npol/Build18_2015/Analog/MCU_Pinouts.xlsx

Sheet: Gate
Pin | Function | Use | Peripheral | Clk
1 | DVCC | 3.3V | Supply | N/A
2 | P1.0/TA0CLK/ACLK/A0/CA0 | LED | P1.0 | N/A
3 | P1.1/TA0.0/UCA0RXD/UCA0SOMI/A1/CA1 | RXD | UCA0_UART | ACLK/1
4 | P1.2/TA0.1/UCA0TXD/UCA0SIMO/A2/CA2 | TXD | UCA0_UART | ACLK/1
5 | P1.3/ADC10CLK/CAOUT/VREF-/VEREF-/A3/CA3 | RFID_RX | ADC3
6 | P1.4/SMCLK/UCB0STE/UCA0CLK/VREF+/VEREF+/A4/CA4 | CS | UCB0_SPI | ACLK/8
7 | P1.5/TA0.0/UCB0CLK/UCA0STE/A5/CA5/TMS | SCK | UCB0_SPI | ACLK/8
8 | P2.0/TA1.0 | GDO0 | P2.1 | N/A
9 | P2.1/TA1.1 | RFID_TX | TA1.1 | ACLK/1
10 | P2.2/TA1.1 | GDO2 | P2.2 | N/A
11 | P2.3/TA1.0 | ID0 | P2.3 | N/A
12 | P2.4/TA1.2 | ID1 | P2.4 | N/A
13 | P2.5/TA1.2 | ID2 | P2.5 | N/A
14 | P1.6/TA0.1/UCB0SOMI/UCB0SCL/A6/CA6/TDI/TCLK | MISO | UCB0_SPI | ACLK/8
15 | P1.7/CAOUT/UCB0SIMO/UCB0SDA/A7/CA7/TDO/TDI | MOSI | UCB0_SPI | ACLK/8
16 | /RST/NMI/SBWTDIO | RST | Prgm | N/A
17 | TEST/SBWTCK |  | Prgrm | N/A
18 | XOUT/P2.7 | XOUT | XTAL | N/A
19 | XIN/P2.6/TA0.1 | XIN | XTAL | N/A
20 | DVSS | GND | Supply | N/A

Sheet: Car-RF
Pin | Function | Use | Peripheral | Clk | RFID_RX1
1 | DVCC | 3.3V | Supply | N/A | RFID_RX2
2 | P1.0/TA0CLK/ACLK/A0/CA0 |  |  |  | RFID_TX
3 | P1.1/TA0.0/UCA0RXD/UCA0SOMI/A1/CA1 | RF_RXD | UCA0_UART | ACLK/1
4 | P1.2/TA0.1/UCA0TXD/UCA0SIMO/A2/CA2 | RF_TXD | UCA0_UART | ACLK/1
5 | P1.3/ADC10CLK/CAOUT/VREF-/VEREF-/A3/CA3 |  |  |  | CS
6 | P1.4/SMCLK/UCB0STE/UCA0CLK/VREF+/VEREF+/A4/CA4
7 | P1.5/TA0.0/UCB0CLK/UCA0STE/A5/CA5/TMS | SCK | UCB0_SPI | ACLK/8
8 | P3.1/TA1.0
9 | P3.0/TA0.2 |  |  |  | GDO0
10 | P2.0/TA1.0 |  |  |  | GDO2
11 | P2.1/TA1.1 |  |  |  | Step
12 | P2.2/TA1.1 |  |  |  | Dir
13 | P3.2/TA1.1 |  |  |  | En
14 | P3.3/TA1.2
15 | P3.4/TA0.0 | ENABLE
16 | P2.3/TA1.0 | DIR
17 | P2.4/TA1.2 | STEP
18 | P2.5/TA1.2
19 | P3.5/TA0.1
20 | P3.6/TA0.2
21 | P3.7/TA0.2
22 | P1.6/TA0.1/UCB0SOMI/UCB0SCL/A6/CA6/TDI/TCLK | MISO | UCB0_SPI | ACLK/8 | Opto
23 | P1.7/CAOUT/UCB0SIMO/UCB0SDA/A7/CA7/TDO/TDI | MOSI | UCB0_SPI | ACLK/8 | LED
24 | /RST/NMI/SBWTDIO | RST | Prgm | N/A | MUX_EN
25 | TEST/SBWTCK |  | Prgrm | N/A | MUX_A0
26 | XOUT/P2.7 | XOUT | XTAL | N/A | MUX_A1
27 | XIN/P2.6/TA0.1 | XIN | XTAL | N/A | Gate1
28 | DVSS | GND | Supply | N/A | Gate2
 |  |  | opto input?

Sheet: Car-Motor
Pin | Function | Use | Peripheral | Clk
1 | DVCC | 3.3V | Supply | N/A
2 | P1.0/TA0CLK/ACLK/A0/CA0 | LED | P1.0 | N/A
3 | P1.1/TA0.0/UCA0RXD/UCA0SOMI/A1/CA1 | RXD | UCA0_UART | ACLK/1
4 | P1.2/TA0.1/UCA0TXD/UCA0SIMO/A2/CA2 | TXD | UCA0_UART | ACLK/1
5 | P1.3/ADC10CLK/CAOUT/VREF-/VEREF-/A3/CA3
6 | P1.4/SMCLK/UCB0STE/UCA0CLK/VREF+/VEREF+/A4/CA4
7 | P1.5/TA0.0/UCB0CLK/UCA0STE/A5/CA5/TMS
8 | P2.0/TA1.0 | A0 | P2.0
9 | P2.1/TA1.1 | A1 | OUT1.1
10 | P2.2/TA1.1 | SLEEP | P2.2
11 | P2.3/TA1.0 | B0 | P2.3
12 | P2.4/TA1.2 | B1 | OUT1.2
13 | P2.5/TA1.2 | FAULT | P2.5
14 | P1.6/TA0.1/UCB0SOMI/UCB0SCL/A6/CA6/TDI/TCLK
15 | P1.7/CAOUT/UCB0SIMO/UCB0SDA/A7/CA7/TDO/TDI
16 | /RST/NMI/SBWTDIO | RST | Prgm | N/A
17 | TEST/SBWTCK |  | Prgrm | N/A
18 | XOUT/P2.7 | XOUT | XTAL | N/A
19 | XIN/P2.6/TA0.1 | XIN | XTAL | N/A
20 | DVSS | GND | Supply | N/A
