npol/Build18_2015/Mobile_Robot_Localization_Parts_List.xlsx

Part Link | Note | Quantity | Est. Cost per unit | Subtotal
http://www.pololu.com/product/2213 | 50:1 Micro metal gearmotor with encoder shaft | 2 | 16.95 | 33.9 | Project Name: | Total Spent:
http://www.pololu.com/product/2591 | Optical encoder pair, 3.3V | 1 | 8.95 | 8.95 | Mobile Robot Localization using RFID | 299.704
http://www.pololu.com/product/1086 | Motor bracket, white | 1 | 4.99 | 4.99
http://www.pololu.com/product/1435 | Wheel 90x10mm Pair Black | 1 | 9.95 | 9.95
http://www.pololu.com/product/951 | Ball Caster 3/8 metal ball | 1 | 2.99 | 2.99
http://www.amazon.com/Magnet-Enameled-Copper-Length-Diameter/dp/B00BJMVMQE | Amazon B00BJMVMQE 22AWG Magnet Wire | 2 | 15.98 | 31.96
http://www.amazon.com/Cast-Acrylic-Sheet-Clear-0-177/dp/B00JB7FEEU | Amazon B006GHT9NA 0.177Thick 12"x24" acrylic sheet, clear | 2 | 15.88 | 31.76 | Point of Contact
http://www.amazon.com/StarTech-com-Thermal-Compound-Heatsink-SILVGREASE1/dp/B00006B8DX | Amazon B00006B8DX Thermal Paste | 1 | 2.99 | 2.99 | npol@andrew.cmu.edu
N/A-Osh Park | Gate PCB: Will purchase, and ask for reimbursement | 1 | 30 | 30
N/A-Osh Park | Car PCB: Will purchase, and ask for reimbursement | 1 | 35 | 35
http://www.digikey.com/product-detail/en/MSP430G2353IPW20/296-33456-5-ND/2695675 | Digikey 296-33456-5-ND MSP430G2353IPW20 Microcontroller | 10 | 0.1764 | 1.764
http://www.digikey.com/product-search/en?KeyWords=QFM-TRX1-24G-ND&WT.z_header=search_go | Digikey QFM-TRX1-24G-ND 2.4GHz Radio | 4 | 6.78 | 27.12
http://www.digikey.com/product-detail/en/951108-8622-AR/3M9327-ND/1959055 | Digikey 3M9327-ND 2mm 8x1 pins | 2 | 0.51 | 1.02
http://www.digikey.com/product-search/en?KeyWords=S5751-08-ND&WT.z_header=search_go | Digikey S5751-08-ND 2mm 8x1 socket | 4 | 1.11 | 4.44
http://www.digikey.com/product-detail/en/OPA564AIDWDR/296-25453-1-ND/2187253 | Digikey 296-25453-1-ND OPA564IDWDR | 3 | 7.13 | 21.39
http://www.digikey.com/product-detail/en/OPA2134UA%2F2K5/296-22024-1-ND/301154 | Digikey 296-22024-1-ND OPA2134UA/2K5 | 5 | 3.63 | 18.15
http://www.digikey.com/product-detail/en/LMC6482IMX%2FNOPB/LMC6482IMX%2FNOPBCT-ND/3440141 | Digikey LMC6482IMX/NOPBCT-ND LMC6482IMX/NOPB | 5 | 1.75 | 8.75
http://www.digikey.com/product-search/en?KeyWords=CTX900-ND&WT.z_header=search_go | Digikey CTX900-ND 8MHz Crystal | 10 | 0.3 | 3
http://www.digikey.com/product-detail/en/1N4732A/1N4732AFS-ND/977205 | Digikey 1N4732AFS-ND 1N4732A | 10 | 0.209 | 2.09
http://www.digikey.com/product-detail/en/1N4742A/1N4742AFS-ND/977257 | Digikey 1N4742AFS-ND 1N4742A | 10 | 0.209 | 2.09
http://www.digikey.com/product-detail/en/SMS3922-015LF/863-1108-1-ND/2052240 | Digikey 863-1108-1-ND SMS3922-015LF | 3 | 0.71 | 2.13
http://www.digikey.com/product-search/en?KeyWords=LM2574N-5.0%2FNOPB-ND&WT.z_header=search_go | Digikey LM2574N-5.0/NOPB-ND LM2574-5.0 | 2 | 1.99 | 3.98
http://www.digikey.com/product-search/en?KeyWords=553-1558-5-ND&WT.z_header=search_go | Digikey 553-1558-5-ND 330uH inductor | 1 | 3.15 | 3.15
http://www.digikey.com/product-detail/en/2N7002P,215/568-5818-1-ND/2531105 | Digikey 568-5818-1-ND 2N7002P SOT-23 | 10 | 0.127 | 1.27
http://www.digikey.com/product-detail/en/BS250FTA/BS250FCT-ND/53566 | Digikey BS250FCT-ND BS250FTA | 2 | 0.7 | 1.4
http://www.digikey.com/product-detail/en/MAX4518CSD%2B/MAX4518CSD%2B-ND/1780268 | Digikey MAX4518CSD+-ND Analog Multiplexer | 1 | 2.08 | 2.08
http://www.digikey.com/product-search/en?KeyWords=425-1948-5-ND&WT.z_header=search_go | Digikey 425-1948-5-ND Optointerrupter | 1 | 1.43 | 1.43
http://www.digikey.com/product-detail/en/LD1117D33CTR/497-1230-1-ND/586230 | Digikey 497-1230-1-ND LD1117D33CTR | 4 | 0.49 | 1.96
 |  |  |  | 0
 |  |  |  | 0
 |  |  |  | 0
 |  |  |  | 0
 |  |  |  | 0
 |  |  |  | 0
 |  |  |  | 0
 |  |  |  | 0
 |  |  |  | 0
 |  |  |  | 0
 |  |  |  | 0
 |  |  |  | 0
 |  |  |  | 0
 |  |  |  | 0
 |  |  |  | 0
 |  |  |  | 0
 |  |  |  | 0
 |  |  |  | 0
 |  |  |  | 0
 |  |  |  | 0
 |  |  |  | 0
 |  |  |  | 0
 |  |  |  | 0
 |  |  |  | 0
 |  |  |  | 0
 |  |  |  | 0
