npol/Build18_2015/Analog/Robot/BBB Setup.docx

BBB Setup

UART testing

Port 1 OK, /dev/ttyO1

Port 2 OK, /dev/ttyO2

Port 3 not working

Port 4 OK, /dev/ttyO4

Port 5 not working

GPIO testing

P8_26 works

P8_19 works
