npol/Build18_2015/Analog/RFID_Scanner/tests/scanner_prelim/bias_filter_opa2312.png

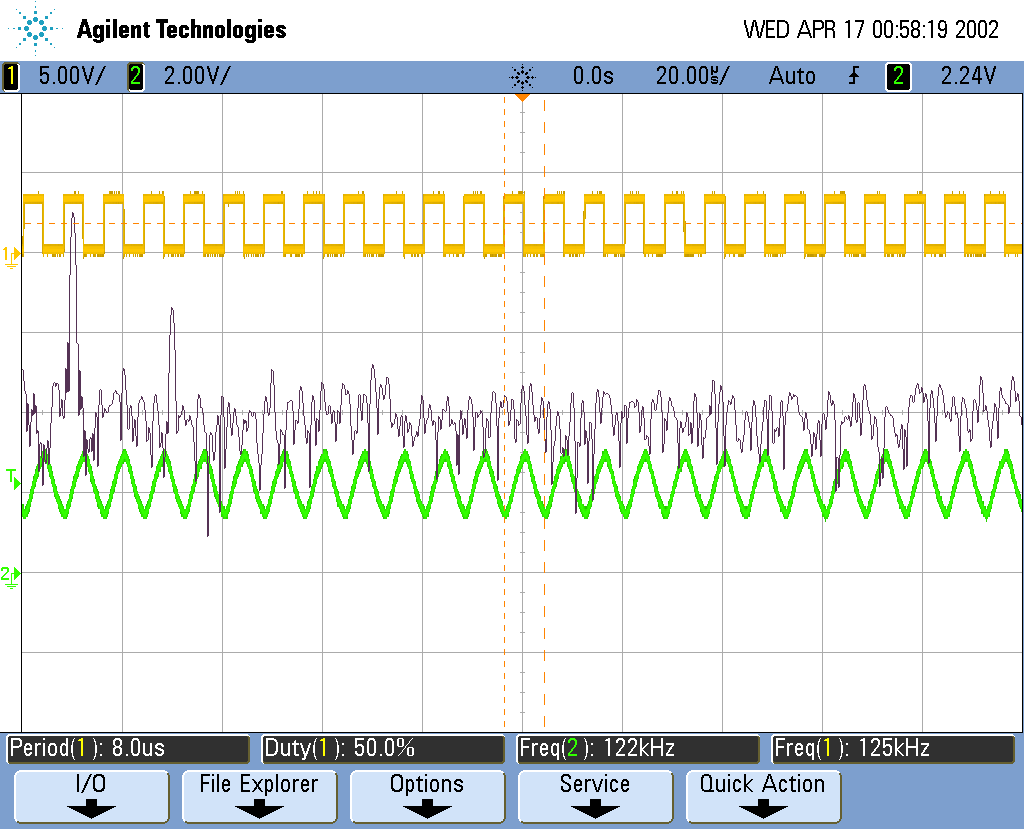
Analog/RFID_Scanner/tests/scanner_prelim/bias_filter_opa2312.png
