npol/Build18_2015/Analog/RFID_Scanner/tests/scanner_prelim/OPA547_follower_sine.png

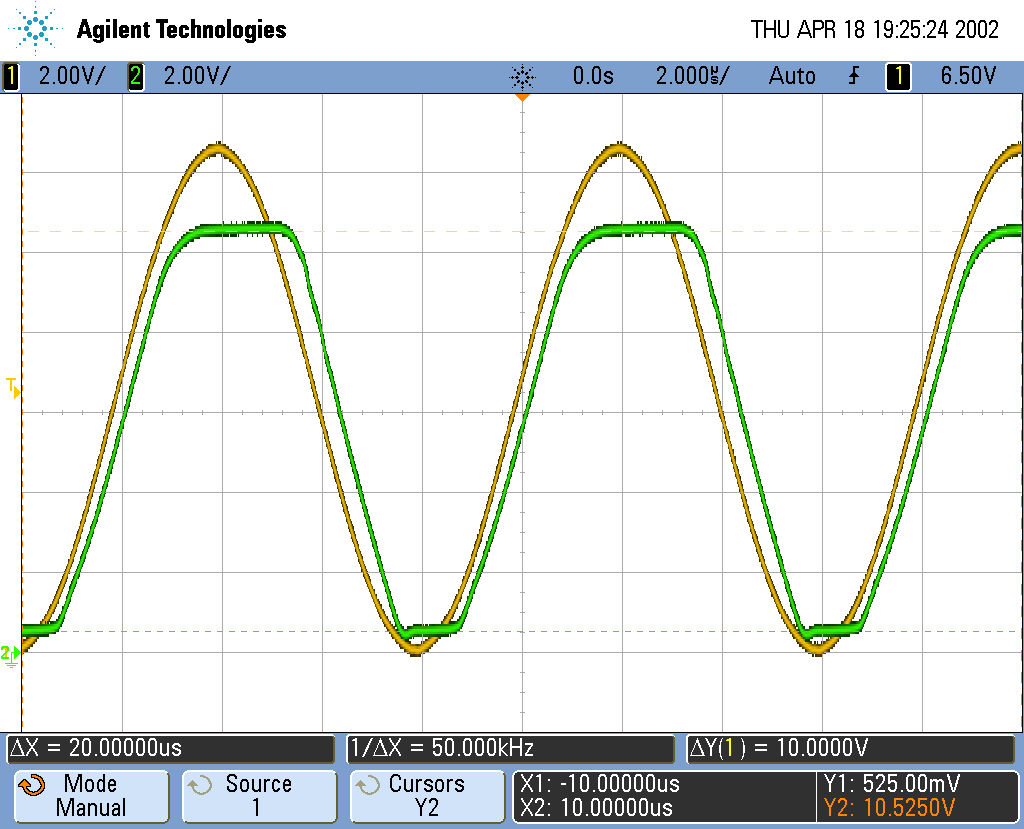
Analog/RFID_Scanner/tests/scanner_prelim/OPA547_follower_sine.png
