npol/Build18_2015/Analog/RFID_Scanner/tests/scanner_prelim/Tx_OPA547_noload.png

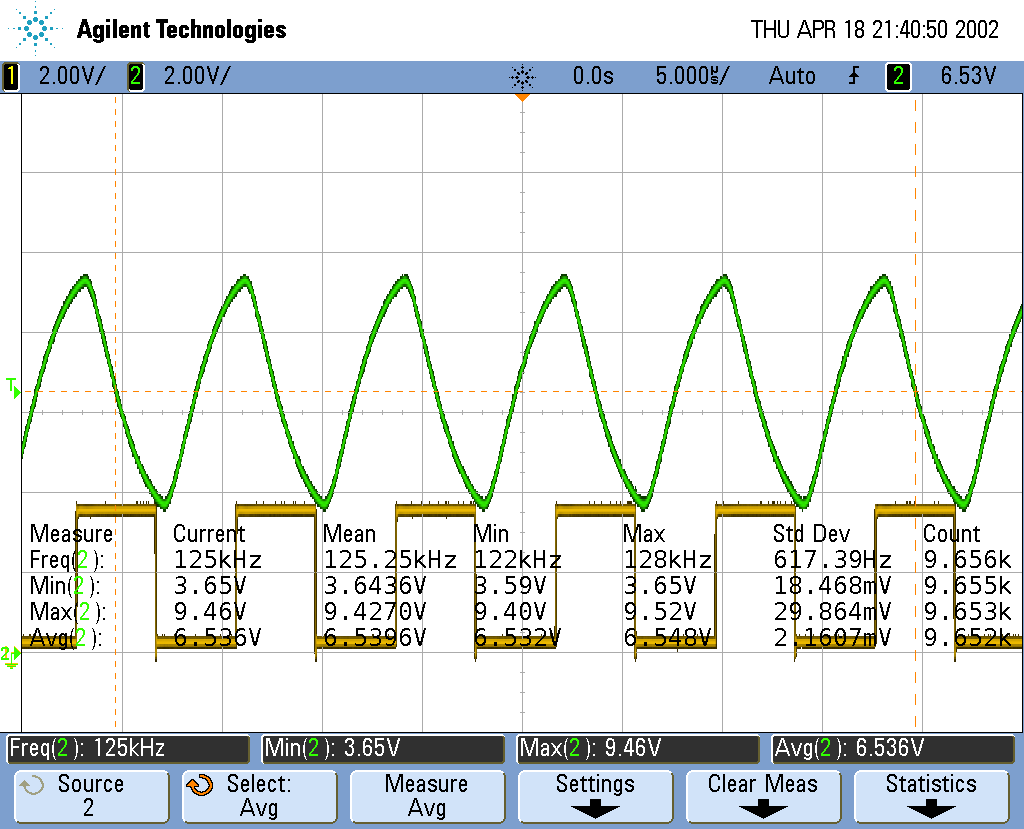
Analog/RFID_Scanner/tests/scanner_prelim/Tx_OPA547_noload.png
