npol/Build18_2015/Analog/RFID_Scanner/tests/scanner_prelim/Tx_slew.png

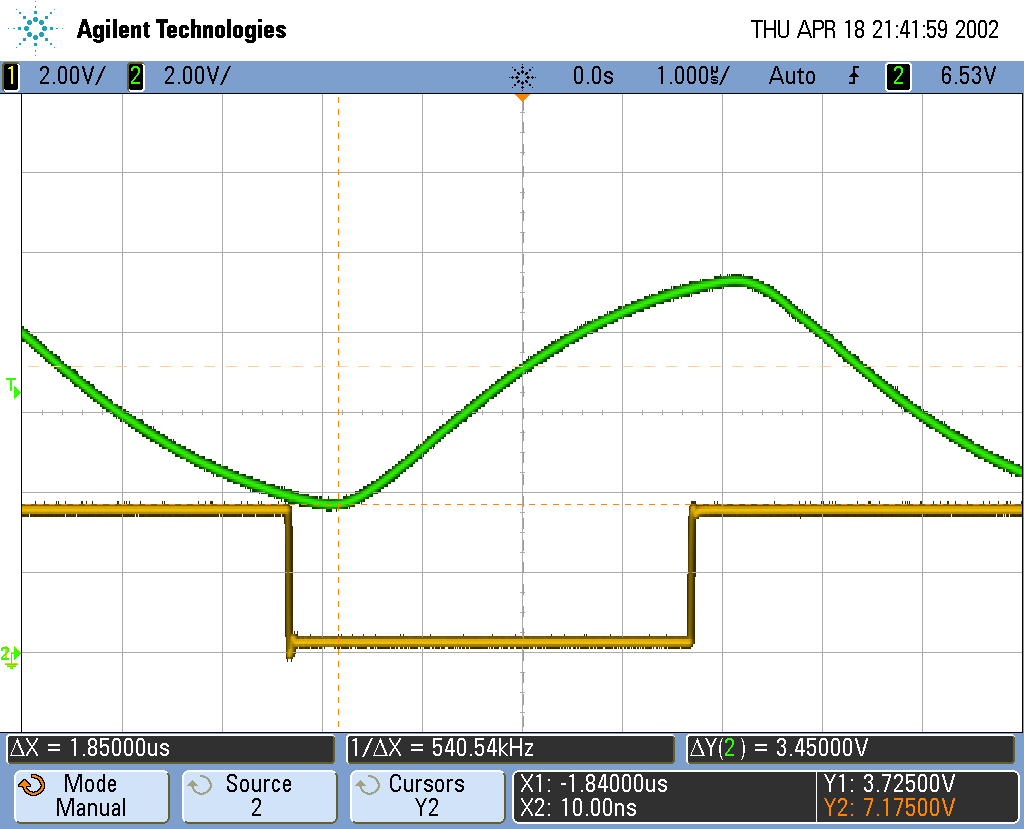
Analog/RFID_Scanner/tests/scanner_prelim/Tx_slew.png
