npol/Build18_2015/Analog/Robot/PCB/Shield.pdf

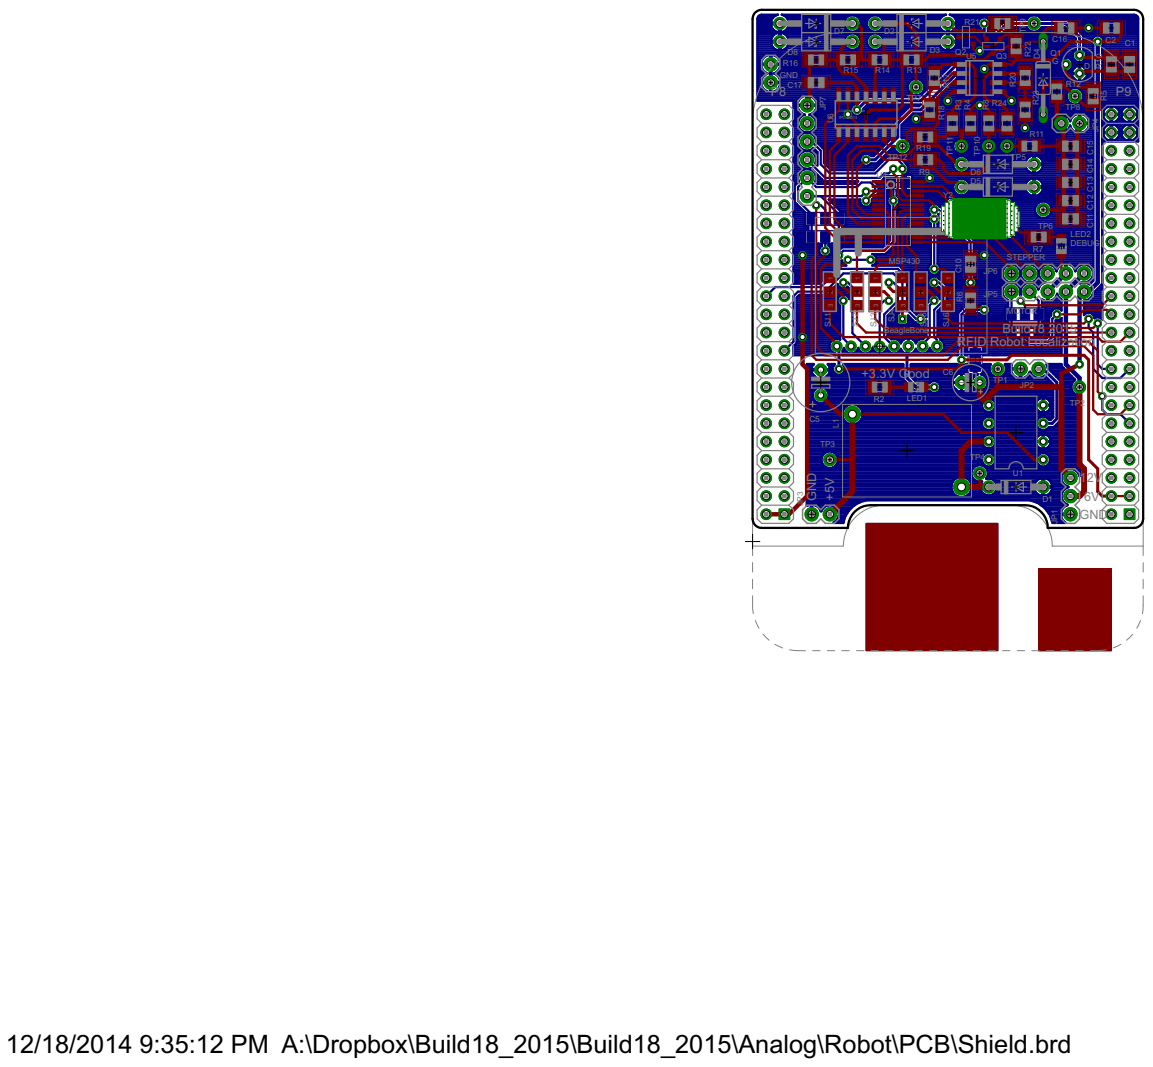
[picture p14: page 1]

GND

BeagleBone | Build18 2015 RFID Robot Localization

12/18/2014 9:35:12 PM A:\Dropbox\Build18_2015\Build18_2015\Analog\Robot\PCB\Shield.brd
