npol/Build18_2015/Analog/Robot/PCB/Shield.brd

## EAGLE design Analog/Robot/PCB/Shield.brd (2014-12-30)

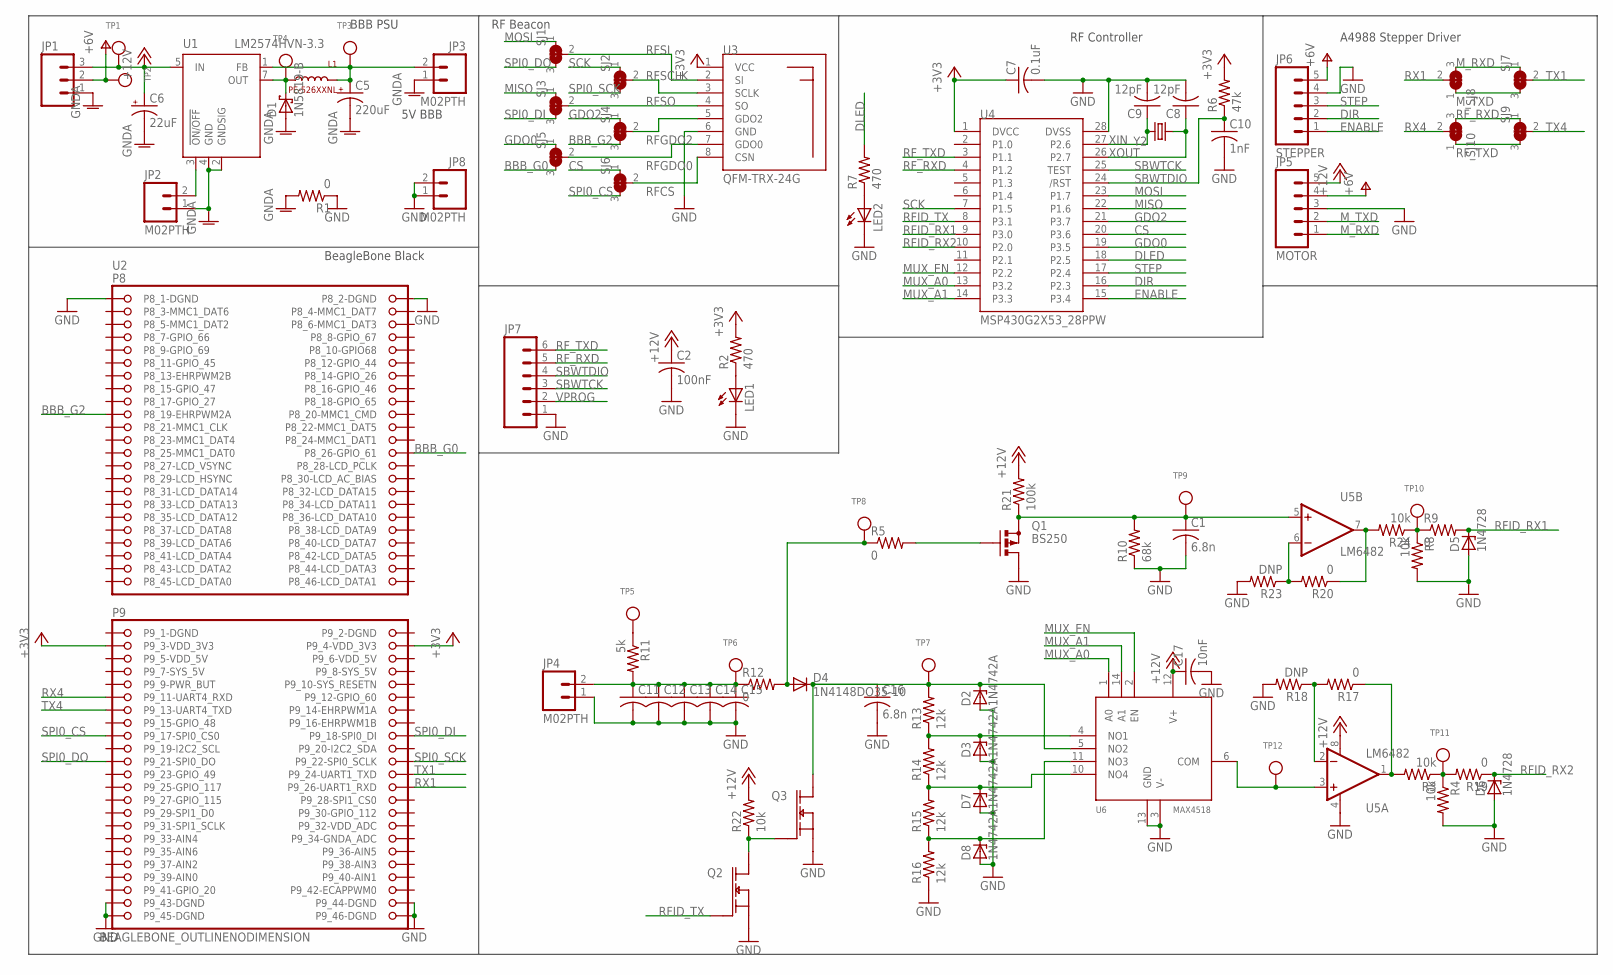
[picture p15: schematic Shield.sch]

Parts:
C1, C16: 6.8n; C0805
C2: 100nF; C0805
C5: 220uF; E3,5-8
C6: 22uF; E2,5-5
C7: 0.1uF; C0805
C8, C9: 12pF; C0805
C10: 1nF; C0805
C11, C12, C13, C14, C15: C-USC0805; C0805
C17: 10nF; C0805
D1: 1N5819-B; DO41-7.6
D2, D3, D7, D8: 1N4742A; DO41Z10
D4: 1N4148DO35-10; DO35-10
D5, D6: 1N4728; DO41Z10
JP1: M03PTH; 1X03
JP2, JP3, JP4, JP8: M02PTH; 1X02
JP5: MOTOR; 1X05
JP6: STEPPER; 1X05
JP7: M06SIP; 1X06
L1: PE-526XXNL; PE_VERTICAL
LED1, LED2: LEDCHIP-LED0805; CHIP-LED0805
Q1: BS250; SOT54E
Q2, Q3: 2N7002_SINGLESOT23/TO-236AB; TO-236AB
R1, R5, R9, R12, R17, R19, R20: 0; R0805
R2, R7: 470; R0805
R3, R4, R8, R22, R24: 10k; R0805
R6: 47k; R0805
R10: 68k; R0805
R11: 5k; R0805
R13, R14, R15, R16: 12k; R0805
R18, R23: DNP; R0805
R21: 100k; R0805
SJ1, SJ2, SJ3, SJ4, SJ5, SJ6, SJ7, SJ8, SJ9, SJ10: SOLDERJUMPER_2WAY0805; SOLDERJUMPER_2WAY_OPEN_0805
TP1, TP2, TP3, TP4, TP5, TP6, TP7, TP8, TP9, TP10, TP11, TP12: TESTPOINT0.1"; 1X01_ROUND
U1: LM2574HVN-3.3; DIL08
U2: BEAGLEBONE_OUTLINENODIMENSION; BEAGLEBONE_SHIELD_NODIMENSION
U3: QFM-TRX-24G; QFM-TRX1-24G
U4: MSP430G2X53_28PPW; PW(R-PDSO-G28)
U5: LM6482; SOIC8
U6: MAX4518; SO-14
Y2: CRYSTALHC49UV; HC49U-V

Connections:
+3V3: C7.1, R2.2, R6.2, U2.9.3 (P9_3-VDD_3V3), U2.9.4 (P9_4-VDD_3V3), U3.1 (VCC), U4.1 (DVCC)
+12V: C2.1, C6.+, C17.1, JP1.3, JP5.5, R21.2, R22.2, TP1.1, U1.5 (IN), U5.8 (V+), U6.12 (V+)
BBB_G0: SJ5.3, U2.8.26 (P8_26-GPIO_61)
BBB_G2: SJ4.3, U2.8.19 (P8_19-EHRPWM2A)
CS: SJ6.1, U4.20 (P3.6)
DIR: JP6.2, U4.16 (P2.3)
DLED: R7.2, U4.18 (P2.5)
ENABLE: JP6.1, U4.15 (P3.4)
GDO0: SJ5.1, U4.19 (P3.5)
GDO2: SJ4.1, U4.21 (P3.7)
GND: C1.2, C2.2, C7.2, C8.2, C9.2, C10.2, C11.2, C12.2, C13.2, C14.2, C15.2, C16.2, C17.2, D2.A, D3.A, D5.A, D6.A, D7.A, D8.A, JP4.1, JP5.3, JP6.4, JP7.1, JP8.1, JP8.2, LED1.C, LED2.C, Q1.D, Q2.2 (S), Q3.2 (S), R1.1, R4.2, R8.2, R10.1, R16.1, R18.2, R23.2, U2.8.1 (P8_1-DGND), U2.8.2 (P8_2-DGND), U2.9.43 (P9_43-DGND), U2.9.44 (P9_44-DGND), U2.9.45 (P9_45-DGND), U2.9.46 (P9_46-DGND), U3.6 (GND), U4.28 (DVSS), U5.4 (V-), U6.3 (V-), U6.13 (GND)
GNDA: C5.-, C6.-, D1.A, JP1.1, JP2.1, JP3.1, R1.2, U1.2 (GNDSIG), U1.4 (GND)
MISO: SJ3.1, U4.22 (P1.6)
MOSI: SJ1.1, U4.23 (P1.7)
MUX_A0: U4.13 (P3.2), U6.1 (A0)
MUX_A1: U4.14 (P3.3), U6.14 (A1)
MUX_EN: U4.12 (P2.2), U6.2 (EN)
M_RXD: JP5.1, SJ7.1, SJ8.3
M_TXD: JP5.2, SJ7.3, SJ8.1
unnamed: R11.1, TP5.1
unnamed: LED2.A, R7.1
unnamed: D1.C, L1.2, TP4.1, U1.7 (OUT)
unnamed: C5.+, JP3.2, L1.1, TP3.1, U1.1 (FB)
unnamed: JP2.2, U1.3 (!ON/OFF)
unnamed: TP12.1, U5.3 (+IN), U6.6 (COM)
unnamed: C11.1, C12.1, C13.1, C14.1, C15.1, JP4.2, R11.2, R12.1, TP6.1
unnamed: D4.A, R5.1, R12.2, TP8.1
unnamed: C16.1, D2.C, D4.C, Q3.3 (D), R13.2, TP7.1, U6.5 (NO2)
unnamed: R20.2, R23.1, U5.6 (-IN)
unnamed: R20.1, R24.2, U5.7 (OUT)
unnamed: R17.2, R18.1, U5.2 (-IN)
unnamed: R8.1, R9.1, R24.1, TP10.1
unnamed: R3.2, R17.1, U5.1 (OUT)
unnamed: R3.1, R4.1, R19.2, TP11.1
unnamed: D3.C, R13.1, R14.2, U6.4 (NO1)
unnamed: D7.C, R14.1, R15.2, U6.10 (NO4)
unnamed: D8.C, R15.1, R16.2, U6.11 (NO3)
unnamed: C1.1, Q1.S, R10.2, R21.1, TP9.1, U5.5 (+IN)
unnamed: Q2.3 (D), Q3.1 (G), R22.1
unnamed: Q1.G, R5.2
unnamed: LED1.A, R2.1
P9_1-DGND: U2.9.1 (P9_1-DGND)
P9_2-DGND: U2.9.2 (P9_2-DGND)
P9_5-VDD_5V: U2.9.5 (P9_5-VDD_5V)
P9_6-VDD_5V: U2.9.6 (P9_6-VDD_5V)
P9_7-SYS_5V: U2.9.7 (P9_7-SYS_5V)
P9_39-AIN0: U2.9.39 (P9_39-AIN0)
RFCS: SJ6.2, U3.8 (CSN)
RFGDO0: SJ5.2, U3.7 (GDO0)
RFGDO2: SJ4.2, U3.5 (GDO2)
RFID_RX1: D5.C, R9.2, U4.9 (P3.0)
RFID_RX2: D6.C, R19.1, U4.10 (P2.0)
RFID_TX: Q2.1 (G), U4.8 (P3.1)
RFSCLK: SJ2.2, U3.3 (SCLK)
RFSI: SJ1.2, U3.2 (SI)
RFSO: SJ3.2, U3.4 (SO)
RF_RXD: JP7.5, SJ9.1, SJ10.3, U4.4 (P1.2)
RF_TXD: JP7.6, SJ9.3, SJ10.1, U4.3 (P1.1)
RX1: SJ8.2, U2.9.26 (P9_26-UART1_RXD)
RX4: SJ10.2, U2.9.11 (P9_11-UART4_RXD)
SBWTCK: JP7.3, U4.25 (TEST)
SBWTDIO: C10.1, JP7.4, R6.1, U4.24 (/RST)
SCK: SJ2.1, U4.7 (P1.5)
SPI0_CS: SJ6.3, U2.9.17 (P9_17-SPI0_CS0)
SPI0_DI: SJ3.3, U2.9.18 (P9_18-SPI0_DI)
SPI0_DO: SJ1.3, U2.9.21 (P9_21-SPI0_DO)
SPI0_SCK: SJ2.3, U2.9.22 (P9_22-SPI0_SCLK)
STEP: JP6.3, U4.17 (P2.4)
TX1: SJ7.2, U2.9.24 (P9_24-UART1_TXD)
TX4: SJ9.2, U2.9.13 (P9_13-UART4_TXD)
V+: JP1.2, JP5.4, JP6.5, TP2.1
VPROG: JP7.2
XIN: C9.1, U4.27 (P2.6), Y2.2
XOUT: C8.1, U4.26 (P2.7), Y2.1

Notes on the sheet:
RF Controller
5V BBB
RF Beacon
A4988 Stepper Driver
BBB PSU
BeagleBone Black

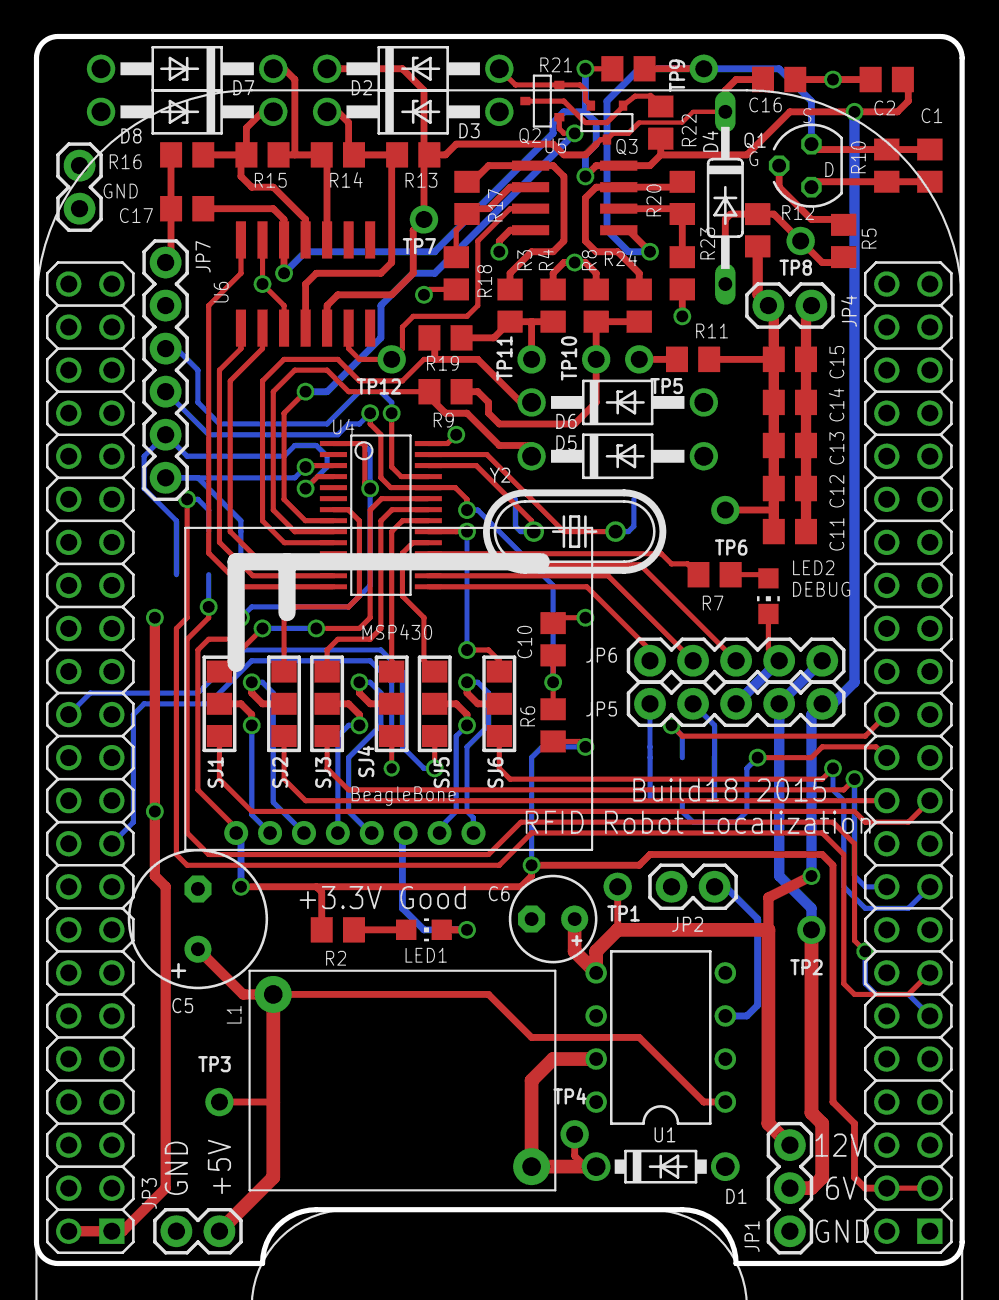
[picture p16: board Shield.brd from above]

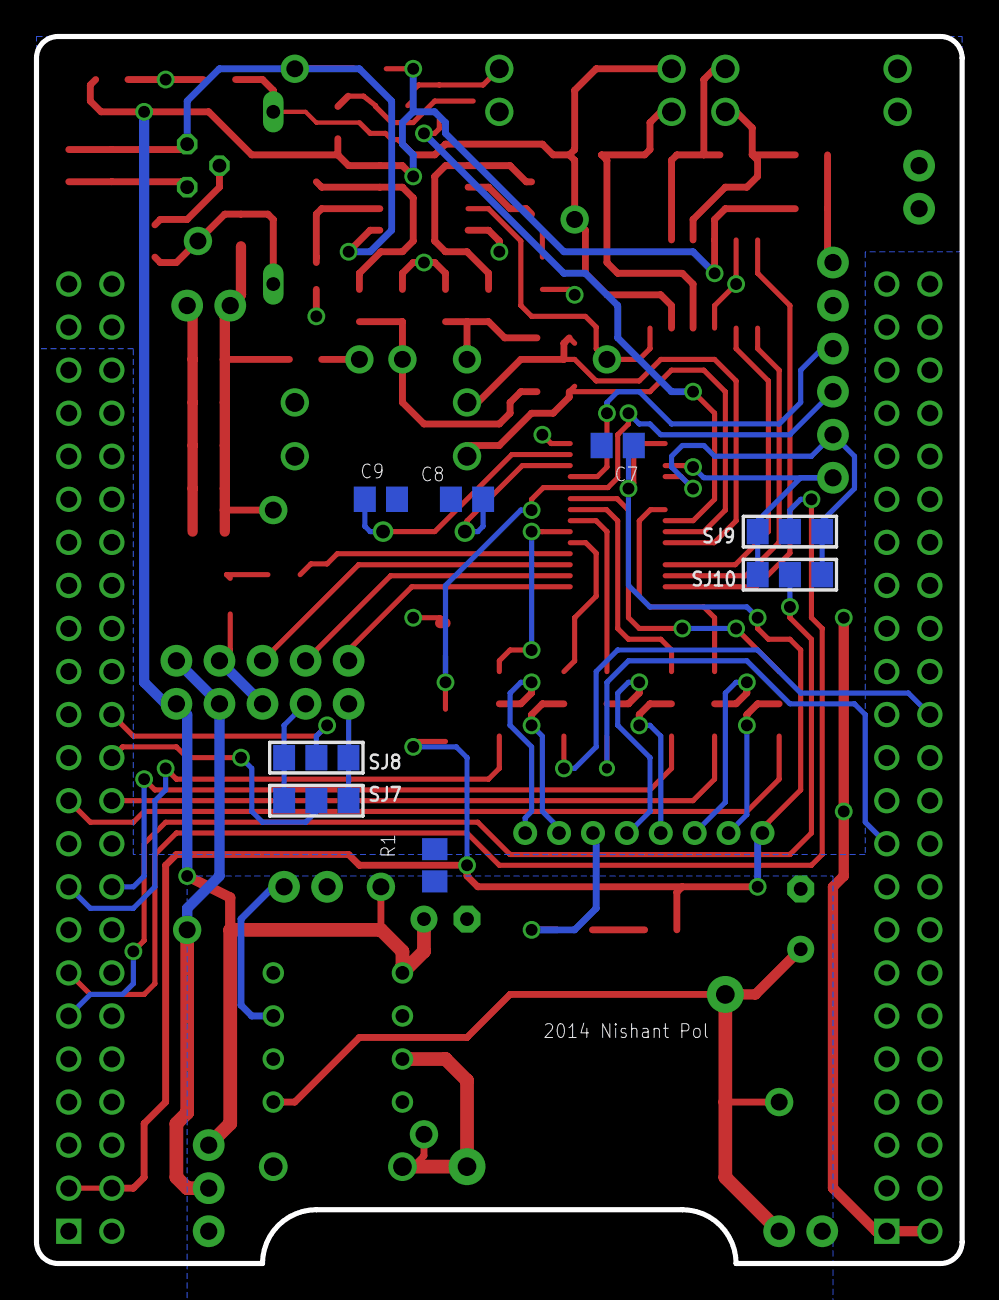
[picture p17: board Shield.brd from below]

Board: 2 copper layers, 54.6 x 72.4 mm, 90 parts (8 on the bottom side), 67 nets.
