npol/Build18_2015/Analog/RFID_Scanner/PCB/Gate_main.brd

## EAGLE design Analog/RFID_Scanner/PCB/Gate_main.brd (2014-12-30)

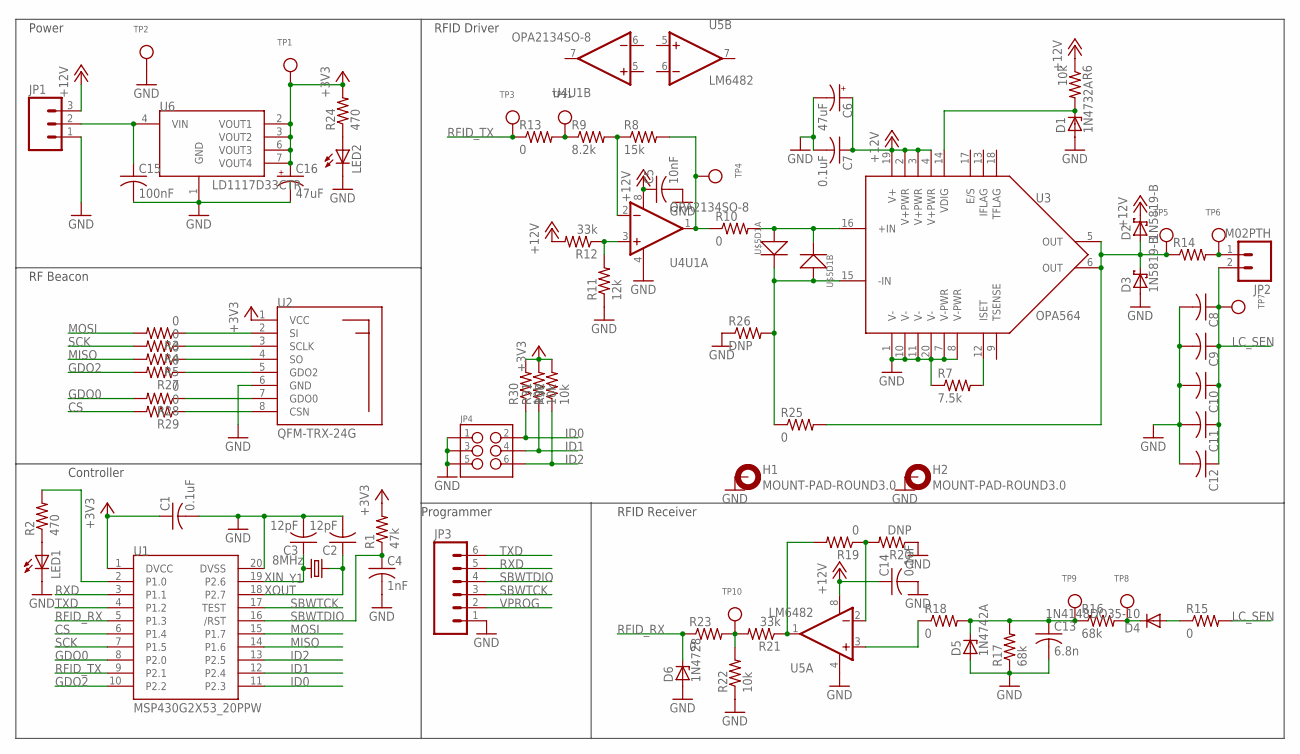
[picture p18: schematic Gate_main.sch]

Parts:
C1, C7, C14: 0.1uF; C0805
C2, C3: 12pF; C0805
C4: 1nF; C0805
C5: 10nF; C0805
C6, C16: 47uF; E2,5-6
C8, C9, C10, C11, C12: C-USC0805; C0805
C13: 6.8n; C0805
C15: 100nF; C0805
D1: 1N4732A; DO41Z10
D2, D3: 1N5819-B; DO41-7.6
D4: 1N4148DO35-10; DO35-10
D5: 1N4742A; DO41Z10
D6: 1N4728; DO41Z10
H1, H2: MOUNT-PAD-ROUND3.0; 3,0-PAD
JP1: M03PTH; 1X03
JP2: M02PTH; 1X02
JP3: M06SIP; 1X06
JP4: M03X22X3_SILK_SM; 2X3
LED1, LED2: LEDCHIPLED_0603; CHIPLED_0603
R1: 47k; R0805
R2, R24: 470; R0805
R3, R4, R5, R10, R13, R15, R18, R19, R23, R25, R27, R28, R29: 0; R0805
R6, R22, R30, R31, R32: 10k; R0805
R7: 7.5k; R0805
R8: 15k; R0805
R9: 8.2k; R0805
R11: 12k; R0805
R12, R21: 33k; R0805
R14: R-US_0207/10; 0207/10
R16, R17: 68k; R0805
R20, R26: DNP; R0805
TP1, TP2, TP3, TP4, TP5, TP6, TP7, TP8, TP9, TP10, TP11: TESTPOINT0.1"; 1X01_ROUND
U1: MSP430G2X53_20PPW; PW(R-PDSO-G20)
U2: QFM-TRX-24G; QFM-TRX1-24G
U3: OPA564; SO-20LD
U4: OPA2134SO-8; SOIC8
U5: LM6482; SOIC8
U6: LD1117D33CTR; SOIC8
U$5: SMS3922-015LF
Y1: 8MHz; HC49U-V

Connections:
+3V3: C1.1, C16.+, R1.2, R24.2, R30.2, R31.2, R32.2, TP1.1, U1.1 (DVCC), U2.1 (VCC), U6.2 (VOUT1), U6.3 (VOUT2), U6.6 (VOUT3), U6.7 (VOUT4)
+6V: C15.1, JP1.2, U6.4 (VIN)
+12V: C5.1, C6.+, C7.1, C14.1, D2.C, JP1.3, R6.1, R12.2, U3.2 (V+PWR), U3.3 (V+PWR), U3.4 (V+PWR), U3.19 (V+), U4.8 (V+), U5.8 (V+)
BIAS_OUT: R8.2, R10.1, TP4.1, U4.1 (OUT)
CS: R29.2, U1.6 (P1.4)
GDO0: R28.2, U1.8 (P2.0)
GDO2: R27.2, U1.10 (P2.2)
GND: C1.2, C2.2, C3.2, C4.2, C5.2, C6.-, C7.2, C8.2, C9.2, C10.2, C11.2, C12.2, C13.2, C14.2, C15.2, C16.-, D1.A, D3.A, D5.A, D6.A, H1.B3,0, H2.B3,0, JP1.1, JP3.1, JP4.1, JP4.3, JP4.5, LED1.C, LED2.C, R7.1, R11.1, R17.1, R20.1, R22.1, R26.1, TP2.1, U1.20 (DVSS), U2.6 (GND), U3.1 (V-), U3.7 (V-PWR), U3.8 (V-PWR), U3.10 (V-), U3.11 (V-), U3.20 (V-), U4.4 (V-), U5.4 (V-), U6.1 (GND)
ID0: JP4.2, R30.1, U1.11 (P2.3)
ID1: JP4.4, R31.1, U1.12 (P2.4)
ID2: JP4.6, R32.1, U1.13 (P2.5)
ISET: R7.2, U3.12 (ISET)
LC_SEN: C8.1, C9.1, C10.1, C11.1, C12.1, JP2.2, R15.2, TP7.1
MISO: R5.2, U1.14 (P1.6)
MOSI: R3.2, U1.15 (P1.7)
unnamed: LED1.A, R2.1
unnamed: R5.1, U2.4 (SO)
unnamed: R4.1, U2.3 (SCLK)
unnamed: R3.1, U2.2 (SI)
unnamed: R8.1, R9.2, U4.2 (-IN)
unnamed: R10.2, U3.16 (+IN), U$5.2 (K), U$5.4 (A)
unnamed: R11.2, R12.1, U4.3 (+IN)
unnamed: R9.1, R13.2, TP11.1
unnamed: JP2.1, R14.2, TP6.1
unnamed: D4.C, R16.2, TP8.1
unnamed: D4.A, R15.1
unnamed: R25.1, R26.2, U3.15 (-IN), U$5.1 (K), U$5.3 (A)
unnamed: C13.1, D5.C, R16.1, R17.2, R18.2, TP9.1
unnamed: R19.1, R20.2, U5.2 (-IN)
unnamed: R19.2, R21.1, U5.1 (OUT)
unnamed: R18.1, U5.3 (+IN)
unnamed: R21.2, R22.2, R23.2, TP10.1
unnamed: R2.2, U1.2 (P1.0)
unnamed: LED2.A, R24.1
unnamed: R29.1, U2.8 (CSN)
unnamed: R28.1, U2.7 (GDO0)
unnamed: R27.1, U2.5 (GDO2)
PA_OUT: D2.A, D3.C, R14.1, R25.2, TP5.1, U3.5 (OUT), U3.6 (OUT)
RFID_RX: D6.C, R23.1, U1.5 (P1.3)
RFID_TX: R13.1, TP3.1, U1.9 (P2.1)
RXD: JP3.5, U1.3 (P1.1)
SBWTCK: JP3.3, U1.17 (TEST)
SBWTDIO: C4.1, JP3.4, R1.1, U1.16 (/RST)
SCK: R4.2, U1.7 (P1.5)
TXD: JP3.6, U1.4 (P1.2)
VDIG: D1.C, R6.2, U3.14 (VDIG)
VPROG: JP3.2
XIN: C3.1, U1.19 (P2.6), Y1.2
XOUT: C2.1, U1.18 (P2.7), Y1.1

Notes on the sheet:
RFID Driver
RFID Receiver
Controller
RF Beacon
Power
Programmer

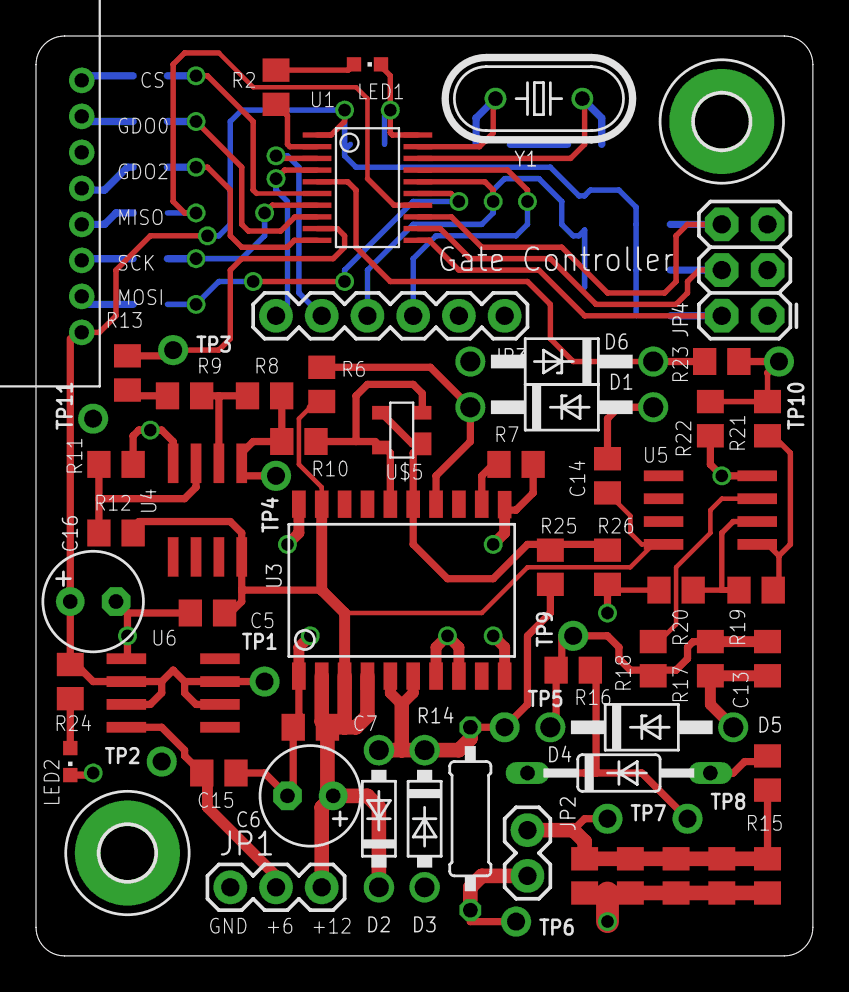
[picture p19: board Gate_main.brd from above]

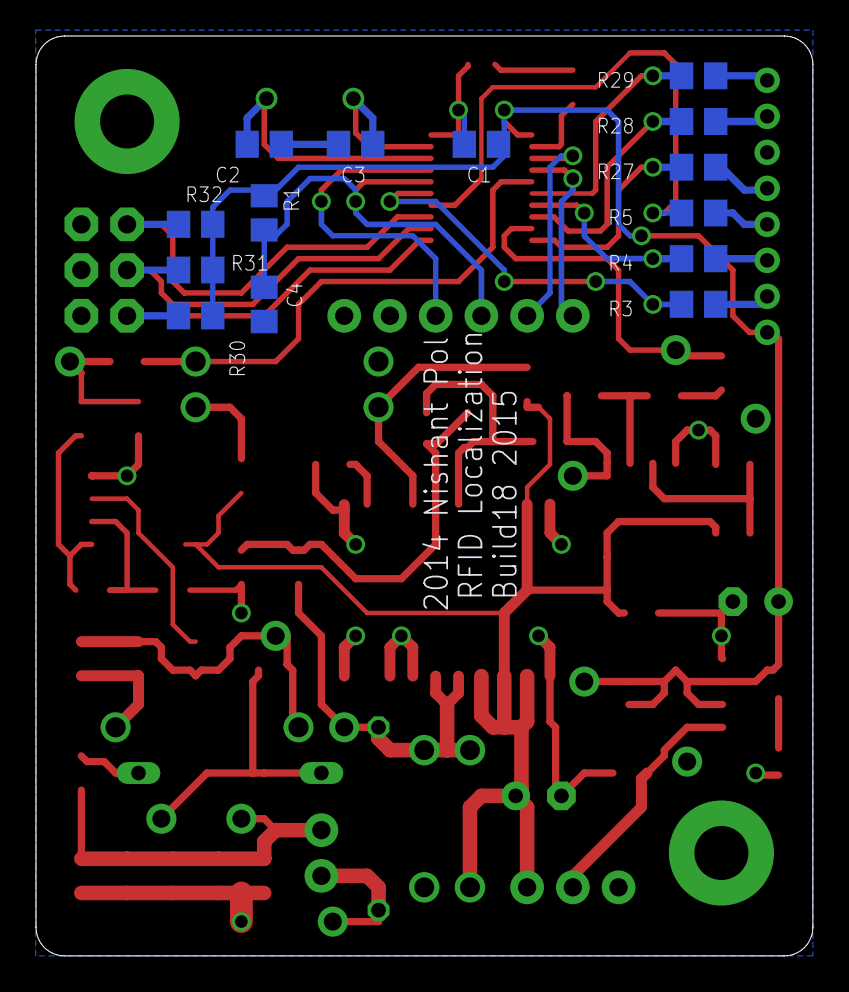
[picture p20: board Gate_main.brd from below]

Board: 2 copper layers, 43.2 x 51.1 mm, 81 parts (14 on the bottom side), 48 nets.
