npol/Build18_2015/Firmware/cc2500_test_tx/utils.h

/*
 * utils.h
 *
 *  Created on: Dec 30, 2014
 *      Author: Nishant Pol
 */

#ifndef UTILS_H_
#define UTILS_H_

#include <msp430.h>

typedef unsigned char uint8_t;
typedef char int8_t;
typedef unsigned int uint16_t;
typedef int int16_t;
typedef unsigned long uint32_t;
typedef long int32_t;
typedef unsigned long long uint64_t;
typedef long long int64_t;




#endif /* UTILS_H_ */
