npol/Build18_2015/(commit log)

2014-11-21 RFID scanner output sim
    Fixed two issues with schematic: power ports were swapped, 741 has
    limited slew which caused it to give triangular output. Using LM318
    instead.
2014-11-21 RFID scanner output sim
    Fixed biasing stage and added 100ohm load. Output clips significantly,
    may want to use different PA
2014-11-25 RFID scanner in/out sim
    Output working, need to adjust resistor values to meet LM318 spec.
    Input is from 220 lab
    [Gate_main.brd, Gate_main.sch, Shield.brd, Shield.sch]
2014-11-27 RFID scanner output sim and test
    Tested Output stage w/o load, using OPA132 as bias/filter amp, and
    OPA547 as power amp. 9V swing
2014-12-13 PCB and firmware
    Gate PCB 70% completed, need to figure out pinout for MCU and layout
    signal amps. Board size reduced by 50%. Also need to add testpoints
    Robot PCB PSU layout completed, motor and stepper drivers will move to
    separate PCB
    Created firmware files, w/o code
    [Gate_main.brd, Gate_main.sch, Mobile_Robot_Localization_Parts_List.xlsx, MotorBoard.sch, Shield.brd, Shield.sch]
2014-12-13 Gate PCB progress
    Did layout for gate pcb signal amps, finalized board size, added
    testpoints
    [Gate_main.brd, Gate_main.sch]
2014-12-30 Board final; SPI progress
    Sent PCBs to FAB
    SPI driver working for multi-byte. Bug: bytes are sent in reversed
    order, although bit ordering (MSB first) is correct.
    [Gate_main.brd, Gate_main.sch, MCU_Pinouts.xlsx, MotorBoard.sch, Shield.brd, Shield.sch, StepperBoard.sch]
2014-12-31 SPI progress
    SPI HAL layer tested: multi-byte tx and rx
    Linking: moved SPI and typedefs to separate files, tested
2014-12-31 SPI progress
    Started API for CC2500, tested strobe and partly read/write to config
    regs
